datacompboy/split-keyboard/README.md

# My very own split keyboard.

Read tutorial on how to build it [in english](how-to-make/building.md) or [in russian](how-to-make/building-ru.md).

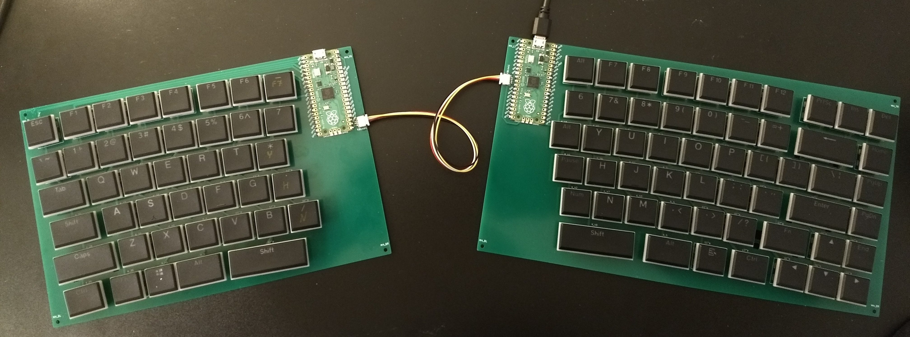
[picture p1: raw-board.jpg]
Just built raw board
