datacompboy/split-keyboard/layout/left-layout-url.md

Links to left layout [URL], [Shortened].

[URL]: http://www.keyboard-layout-editor.com/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
[Shortened]: https://tinyurl.com/2p8awefu
