datacompboy/split-keyboard/layout/right-layout-url.md

Links to right layout: [URL], [Shortened]

[URL]: http://www.keyboard-layout-editor.com/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(%0A9%3B&@_y:0.040000000000000036&x:3.23%3B&=I%3B&@_y:0.029999999999999805&x:3.5%3B&=K%3B&@_y:0.040000000000000036&x:3.85&sb=kailh%3B&=<%0A,%3B&@_y:0.07000000000000028&x:3.5&w:1.5%3B&=Alt%3B&@_r:1&y:-6.3500000000000005&x:4.53&c=%23cccccc%3B&=F10%3B&@_y:0.10000000000000031&x:4.59%3B&=)%0A0%3B&@_y:0.029999999999999805&x:4.3%3B&=O%3B&@_y:0.040000000000000036&x:4.59%3B&=L%3B&@_y:0.020000000000000462&x:4.95%3B&=>%0A.%3B&@_y:0.08000000000000007&x:5.17%3B&=Menu%3B&@_r:2&y:-6.37&x:5.57%3B&=F11%3B&@_y:0.10000000000000009&x:5.64%3B&=%2F_%0A-%3B&@_y:0.029999999999999805&x:5.38%3B&=P%3B&@_y:0.040000000000000036&x:5.69%3B&=%2F:%0A%2F%3B%3B&@_y:0.03000000000000025&x:6.05%3B&=%3F%0A%2F%2F%3B&@_y:0.05999999999999961&x:6.35&w:1.25%3B&=Ctrl%3B&@_r:3&y:-6.38&x:6.6%3B&=F12%3B&@_y:0.1100000000000001&x:6.69%3B&=+%0A%2F=%3B&@_y:0.029999999999999805&x:6.45%3B&=%7B%0A%5B&_x:0.009999999999999787%3B&=%7D%0A%5D%3B&@_y:0.040000000000000036&x:6.78%3B&="%0A'%3B&@_y:0.019999999999999574&x:7.15&w:1.75%3B&=Shift%3B&@_r:4&y:-5.33&x:8%3B&=PrtSc&=Insert&=Delete%3B&@_y:0.10000000000000009&x:7.75&w:2.25%3B&=Backspace&=Home%3B&@_y:0.029999999999999805&x:8.5&w:1.5%3B&=%7C%0A%5C&=PgUp%3B&@_y:0.03000000000000025&x:8&w:2%3B&=Enter&=PgDn%3B&@_y:0.03000000000000025&x:9%3B&=↑&=End%3B&@_y:0.02999999999999936&x:8%3B&=←&=↓&=→%3B&@_r:-3&y:-5.68&x:0.25%3B&=F6%3B&@_y:0.10999999999999988&x:0.37%3B&=%5E%0A6%3B&@_y:0.03000000000000025%3B&=T%3B&@_y:0.040000000000000036&x:0.2%3B&=G%3B&@_y:0.02999999999999936&x:0.51%3B&=B%3B&@_r:-2&y:-5.23&x:1.3%3B&=F7%3B&@_y:0.11000000000000032&x:1.43%3B&=%2F&%0A7%3B&@_y:0.040000000000000036&x:1.08%3B&=Y%3B&@_y:0.03000000000000025&x:1.3%3B&=H%3B&@_y:0.03000000000000025&x:1.62%3B&=N%3B&@_y:0.08999999999999986&x:0.46&a:7&w:2.75%3B&=%3B&@_r:-1&y:-6.34&x:2.35&a:4%3B&=F8%3B&@_y:0.09999999999999964&x:2.49%3B&=*%0A8%3B&@_y:0.040000000000000036&x:2.15%3B&=U%3B&@_y:0.029999999999999805&x:2.4%3B&=J%0A%0A%0A%0A%0A%0A%0A%0A%0A%0A%2F_%3B&@_y:0.02999999999999936&x:2.73%3B&=M
[Shortened]: https://tinyurl.com/3chhv2ky
