datacompboy/split-keyboard/how-to-make/initial-board.png

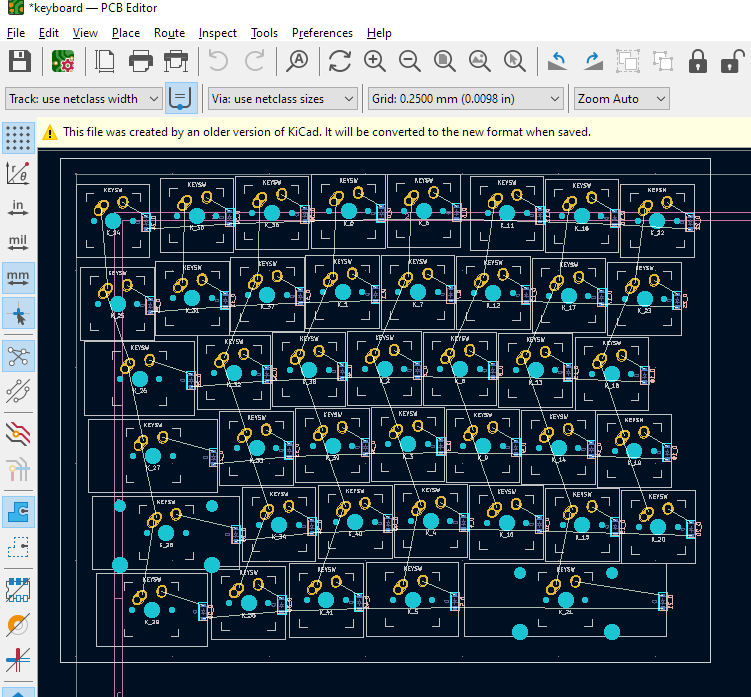
how-to-make/initial-board.png
