datacompboy/split-keyboard/pcb/right-half.kicad_pcb

## KiCad design pcb/right-half.kicad_pcb (2022-06-06)

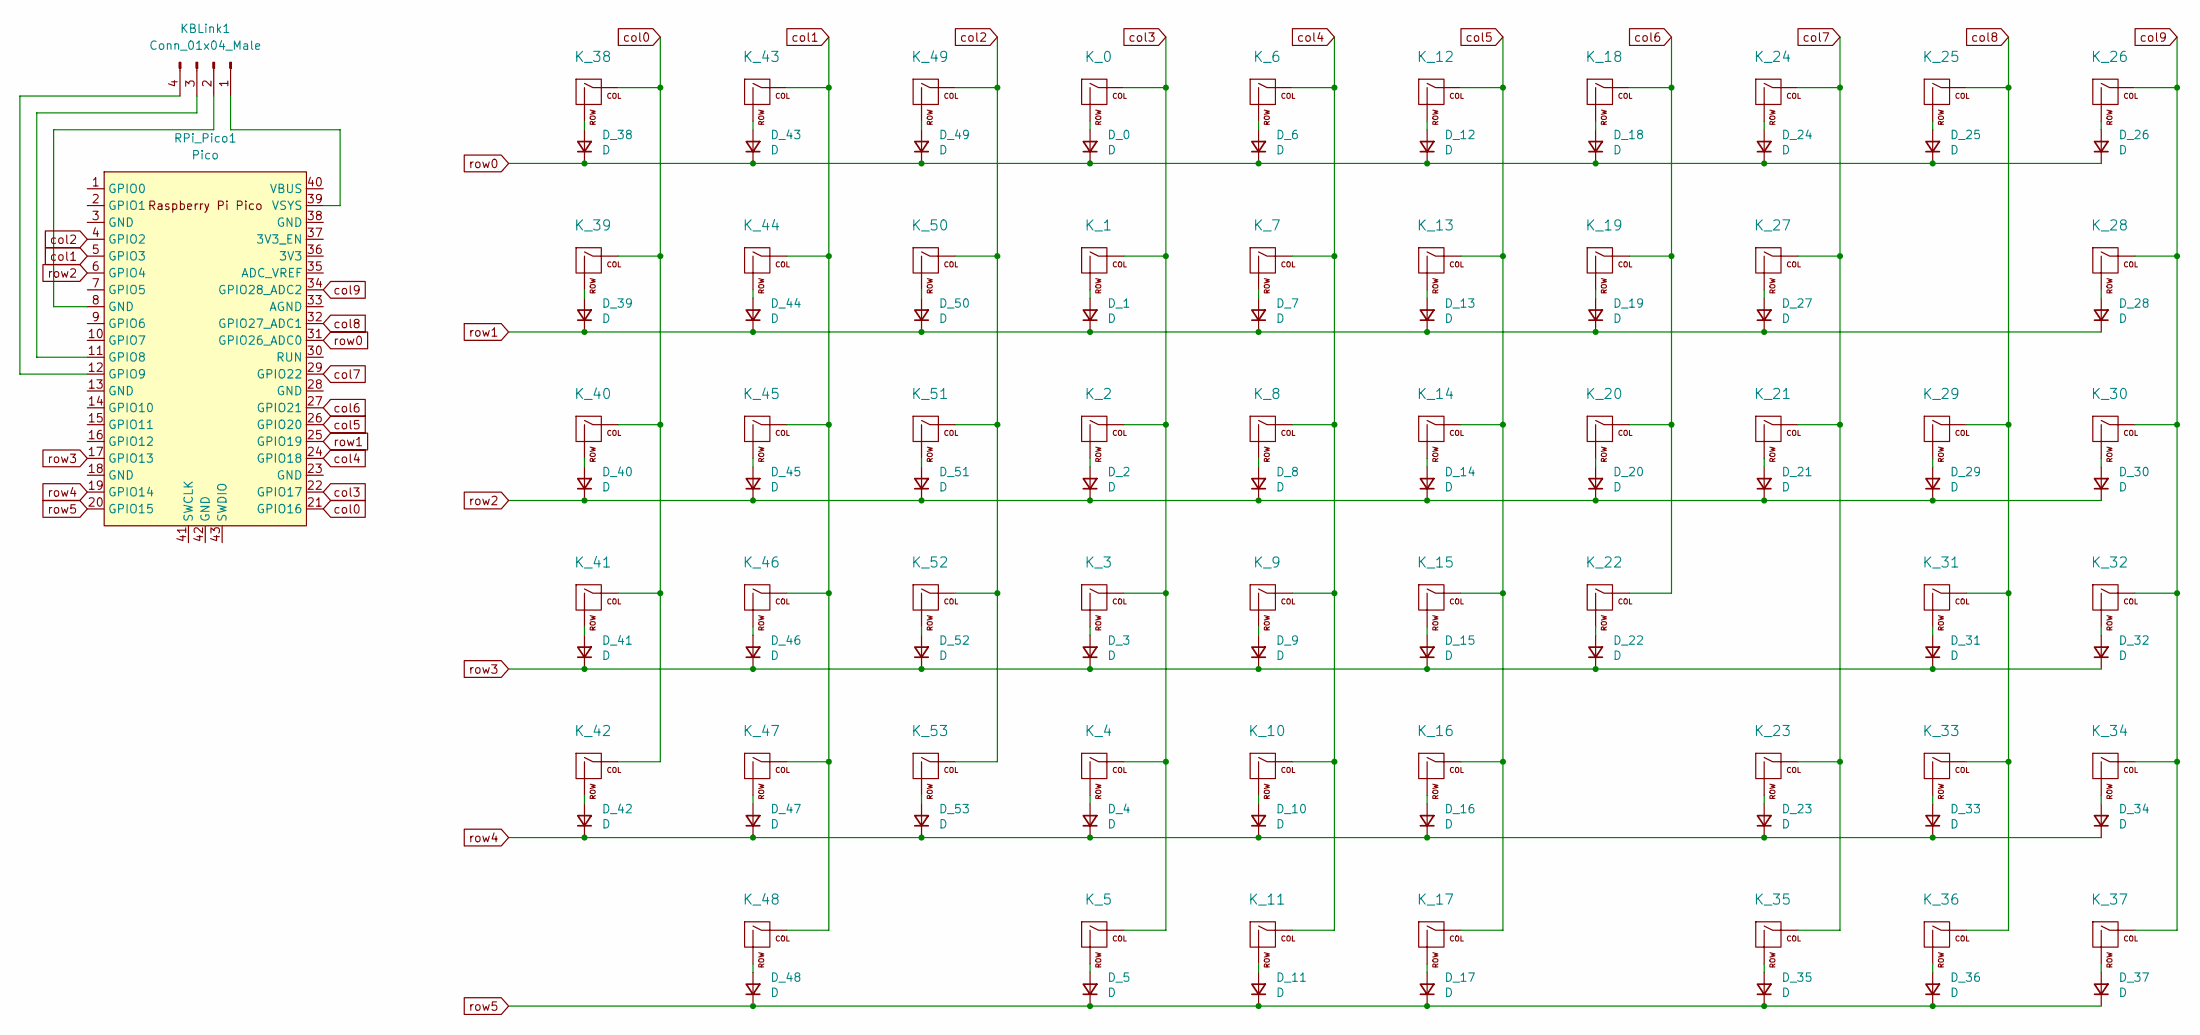
[picture p21: schematic right-half.kicad_sch]

Parts:
D_0, D_1, D_2, D_3, D_4, D_5, D_6, D_7, D_8, D_9, D_10, D_11, D_12, D_13, D_14, D_15, D_16, D_17, D_18, D_19, D_20, D_21, D_22, D_23, D_24, D_25, D_26, D_27, D_28, D_29, D_30, D_31, D_32, D_33, D_34, D_35, D_36, D_37, D_38, D_39, D_40, D_41, D_42, D_43, D_44, D_45, D_46, D_47, D_48, D_49, D_50, D_51, D_52, D_53: D; D_SOD-123
KBLink1: Conn_01x04_Male; JST_SH_SM04B-SRSS-TB_1x04-1MP_P1.00mm_Horizontal
K_0, K_1, K_2, K_3, K_4, K_6, K_7, K_8, K_9, K_10, K_11, K_12, K_13, K_14, K_15, K_16, K_18, K_19, K_20, K_21, K_22, K_24, K_25, K_26, K_28, K_30, K_32, K_33, K_34, K_35, K_36, K_37, K_38, K_39, K_40, K_41, K_42, K_43, K_44, K_45, K_46, K_47, K_49, K_50, K_51, K_52, K_53: KEYSW; MX-1U-NoLED
K_5, K_29: KEYSW; MX-1.5U-NoLED
K_17: KEYSW; MX-1.25U-NoLED
K_23: KEYSW; MX-1.75U-NoLED
K_27: KEYSW; MX-2.25U-NoLED
K_31: KEYSW; MX-2U-NoLED
K_48: KEYSW; MX-2.75U-NoLED
RPi_Pico1: Pico; RPi_Pico_SMD_TH

Connections:
unnamed: D_0.2 (A), K_0.2 (ROW)
unnamed: D_1.2 (A), K_1.2 (ROW)
unnamed: D_2.2 (A), K_2.2 (ROW)
unnamed: D_3.2 (A), K_3.2 (ROW)
unnamed: D_4.2 (A), K_4.2 (ROW)
unnamed: D_5.2 (A), K_5.2 (ROW)
unnamed: D_6.2 (A), K_6.2 (ROW)
unnamed: D_7.2 (A), K_7.2 (ROW)
unnamed: D_8.2 (A), K_8.2 (ROW)
unnamed: D_9.2 (A), K_9.2 (ROW)
unnamed: D_10.2 (A), K_10.2 (ROW)
unnamed: D_11.2 (A), K_11.2 (ROW)
unnamed: D_12.2 (A), K_12.2 (ROW)
unnamed: D_13.2 (A), K_13.2 (ROW)
unnamed: D_14.2 (A), K_14.2 (ROW)
unnamed: D_15.2 (A), K_15.2 (ROW)
unnamed: D_16.2 (A), K_16.2 (ROW)
unnamed: D_17.2 (A), K_17.2 (ROW)
unnamed: D_18.2 (A), K_18.2 (ROW)
unnamed: D_19.2 (A), K_19.2 (ROW)
unnamed: D_20.2 (A), K_20.2 (ROW)
unnamed: D_21.2 (A), K_21.2 (ROW)
unnamed: D_22.2 (A), K_22.2 (ROW)
unnamed: D_23.2 (A), K_23.2 (ROW)
unnamed: D_24.2 (A), K_24.2 (ROW)
unnamed: D_25.2 (A), K_25.2 (ROW)
unnamed: D_26.2 (A), K_26.2 (ROW)
unnamed: D_27.2 (A), K_27.2 (ROW)
unnamed: D_28.2 (A), K_28.2 (ROW)
unnamed: D_29.2 (A), K_29.2 (ROW)
unnamed: D_30.2 (A), K_30.2 (ROW)
unnamed: D_31.2 (A), K_31.2 (ROW)
unnamed: D_32.2 (A), K_32.2 (ROW)
unnamed: D_33.2 (A), K_33.2 (ROW)
unnamed: D_34.2 (A), K_34.2 (ROW)
unnamed: D_35.2 (A), K_35.2 (ROW)
unnamed: D_36.2 (A), K_36.2 (ROW)
unnamed: D_37.2 (A), K_37.2 (ROW)
unnamed: D_38.2 (A), K_38.2 (ROW)
unnamed: D_39.2 (A), K_39.2 (ROW)
unnamed: D_40.2 (A), K_40.2 (ROW)
unnamed: D_41.2 (A), K_41.2 (ROW)
unnamed: D_42.2 (A), K_42.2 (ROW)
unnamed: D_43.2 (A), K_43.2 (ROW)
unnamed: D_44.2 (A), K_44.2 (ROW)
unnamed: D_45.2 (A), K_45.2 (ROW)
unnamed: D_46.2 (A), K_46.2 (ROW)
unnamed: D_47.2 (A), K_47.2 (ROW)
unnamed: D_48.2 (A), K_48.2 (ROW)
unnamed: D_49.2 (A), K_49.2 (ROW)
unnamed: D_50.2 (A), K_50.2 (ROW)
unnamed: D_51.2 (A), K_51.2 (ROW)
unnamed: D_52.2 (A), K_52.2 (ROW)
unnamed: D_53.2 (A), K_53.2 (ROW)
unnamed: KBLink1.1, RPi_Pico1.39 (VSYS)
unnamed: KBLink1.2, RPi_Pico1.8 (GND)
unnamed: KBLink1.3, RPi_Pico1.11 (GPIO8)
unnamed: KBLink1.4, RPi_Pico1.12 (GPIO9)
col0: K_38.1 (COL), K_39.1 (COL), K_40.1 (COL), K_41.1 (COL), K_42.1 (COL), RPi_Pico1.21 (GPIO16)
col1: K_43.1 (COL), K_44.1 (COL), K_45.1 (COL), K_46.1 (COL), K_47.1 (COL), K_48.1 (COL), RPi_Pico1.5 (GPIO3)
col2: K_49.1 (COL), K_50.1 (COL), K_51.1 (COL), K_52.1 (COL), K_53.1 (COL), RPi_Pico1.4 (GPIO2)
col3: K_0.1 (COL), K_1.1 (COL), K_2.1 (COL), K_3.1 (COL), K_4.1 (COL), K_5.1 (COL), RPi_Pico1.22 (GPIO17)
col4: K_6.1 (COL), K_7.1 (COL), K_8.1 (COL), K_9.1 (COL), K_10.1 (COL), K_11.1 (COL), RPi_Pico1.24 (GPIO18)
col5: K_12.1 (COL), K_13.1 (COL), K_14.1 (COL), K_15.1 (COL), K_16.1 (COL), K_17.1 (COL), RPi_Pico1.26 (GPIO20)
col6: K_18.1 (COL), K_19.1 (COL), K_20.1 (COL), K_22.1 (COL), RPi_Pico1.27 (GPIO21)
col7: K_21.1 (COL), K_23.1 (COL), K_24.1 (COL), K_27.1 (COL), K_35.1 (COL), RPi_Pico1.29 (GPIO22)
col8: K_25.1 (COL), K_29.1 (COL), K_31.1 (COL), K_33.1 (COL), K_36.1 (COL), RPi_Pico1.32 (GPIO27_ADC1)
col9: K_26.1 (COL), K_28.1 (COL), K_30.1 (COL), K_32.1 (COL), K_34.1 (COL), K_37.1 (COL), RPi_Pico1.34 (GPIO28_ADC2)
row0: D_0.1 (K), D_6.1 (K), D_12.1 (K), D_18.1 (K), D_24.1 (K), D_25.1 (K), D_26.1 (K), D_38.1 (K), D_43.1 (K), D_49.1 (K), RPi_Pico1.31 (GPIO26_ADC0)
row1: D_1.1 (K), D_7.1 (K), D_13.1 (K), D_19.1 (K), D_27.1 (K), D_28.1 (K), D_39.1 (K), D_44.1 (K), D_50.1 (K), RPi_Pico1.25 (GPIO19)
row2: D_2.1 (K), D_8.1 (K), D_14.1 (K), D_20.1 (K), D_21.1 (K), D_29.1 (K), D_30.1 (K), D_40.1 (K), D_45.1 (K), D_51.1 (K), RPi_Pico1.6 (GPIO4)
row3: D_3.1 (K), D_9.1 (K), D_15.1 (K), D_22.1 (K), D_31.1 (K), D_32.1 (K), D_41.1 (K), D_46.1 (K), D_52.1 (K), RPi_Pico1.17 (GPIO13)
row4: D_4.1 (K), D_10.1 (K), D_16.1 (K), D_23.1 (K), D_33.1 (K), D_34.1 (K), D_42.1 (K), D_47.1 (K), D_53.1 (K), RPi_Pico1.19 (GPIO14)
row5: D_5.1 (K), D_11.1 (K), D_17.1 (K), D_35.1 (K), D_36.1 (K), D_37.1 (K), D_48.1 (K), RPi_Pico1.20 (GPIO15)

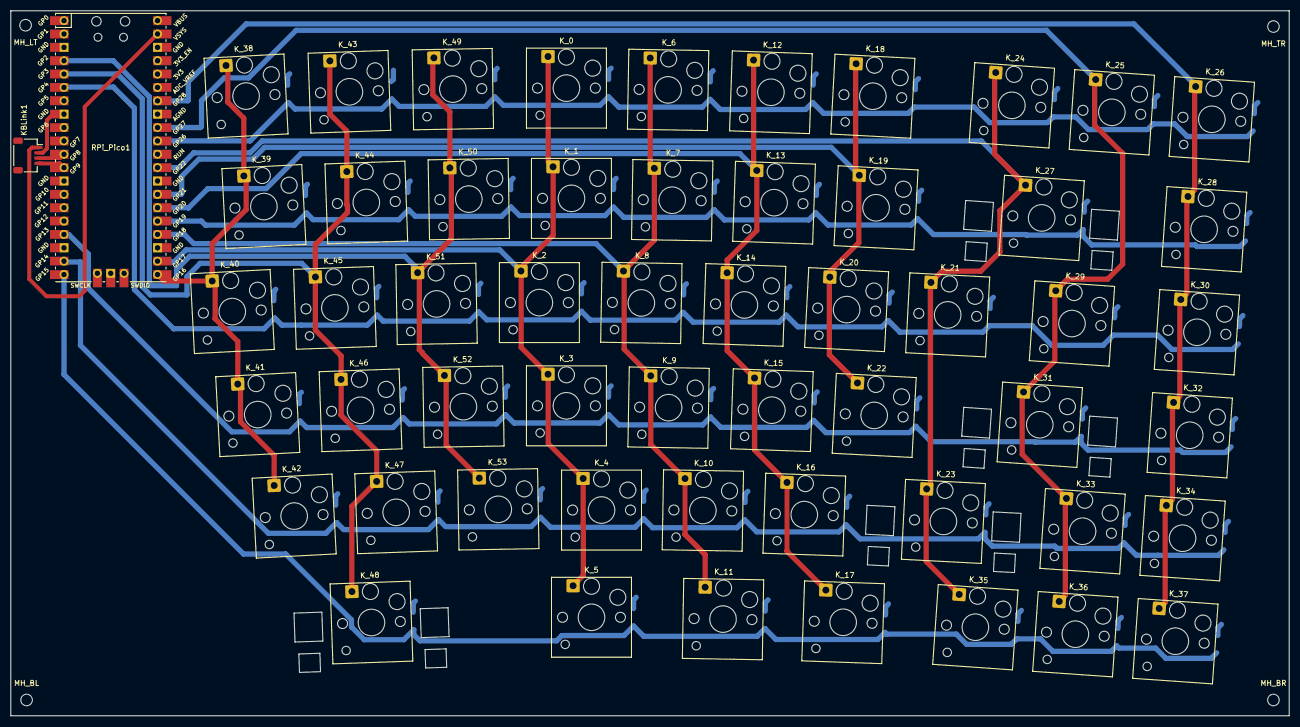
[picture p22: board right-half.kicad_pcb from above]

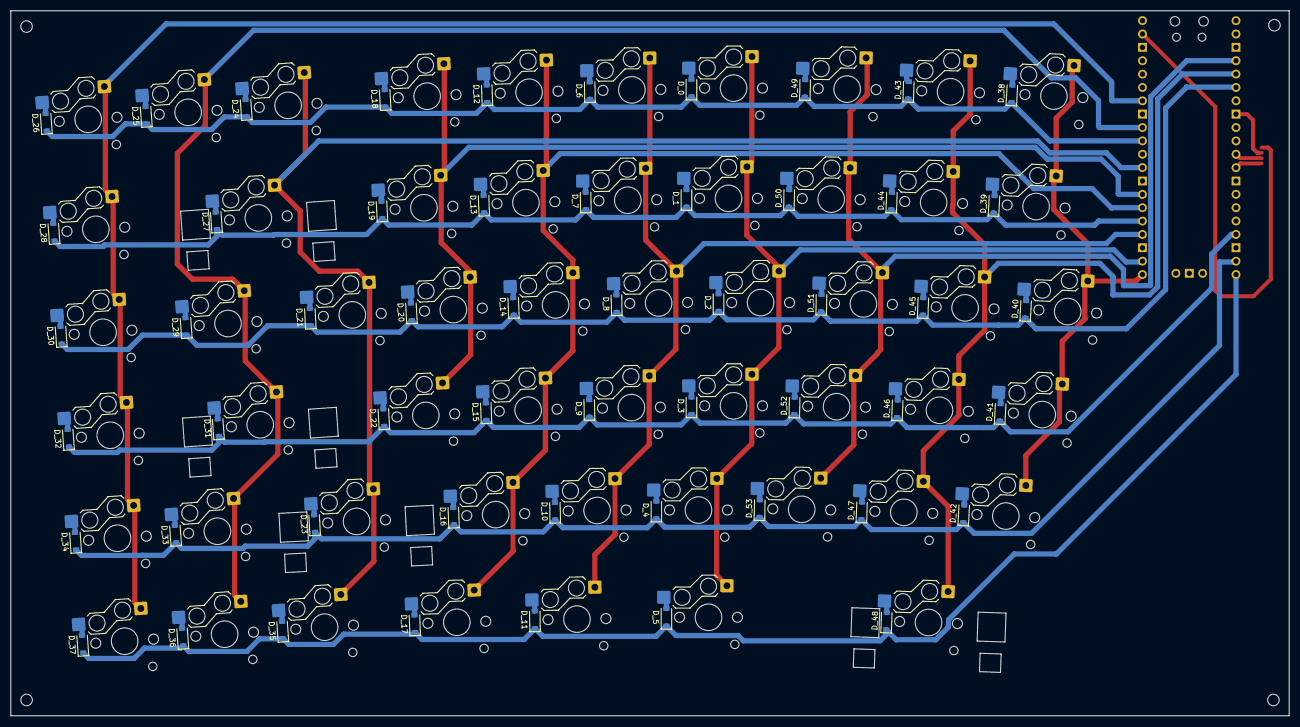
[picture p23: board right-half.kicad_pcb from below]

Board: 2 copper layers, 243.0 x 134.0 mm, 118 parts (54 on the bottom side), 74 nets.

Other parts of the board:
MH_BL: MountingHole_2.2mm_M2
MH_BR: MountingHole_2.2mm_M2
MH_LT: MountingHole_2.2mm_M2
MH_TR: MountingHole_2.2mm_M2
ST_23, ST_27, ST_31, ST_48: Choc; Stab-PG1350-2u.kicad_mod
